bilalmuhammadnaveed/arduino-battery-voltage-tester/docs/ExhibitionTitlePage.pdf

# Battery Voltage Tester

# Using Arduino and LCD Display

Department of Computer Engineering
