bilalmuhammadnaveed/arduino-battery-voltage-tester/SchematicDiagram/schematicDiagram.pdf

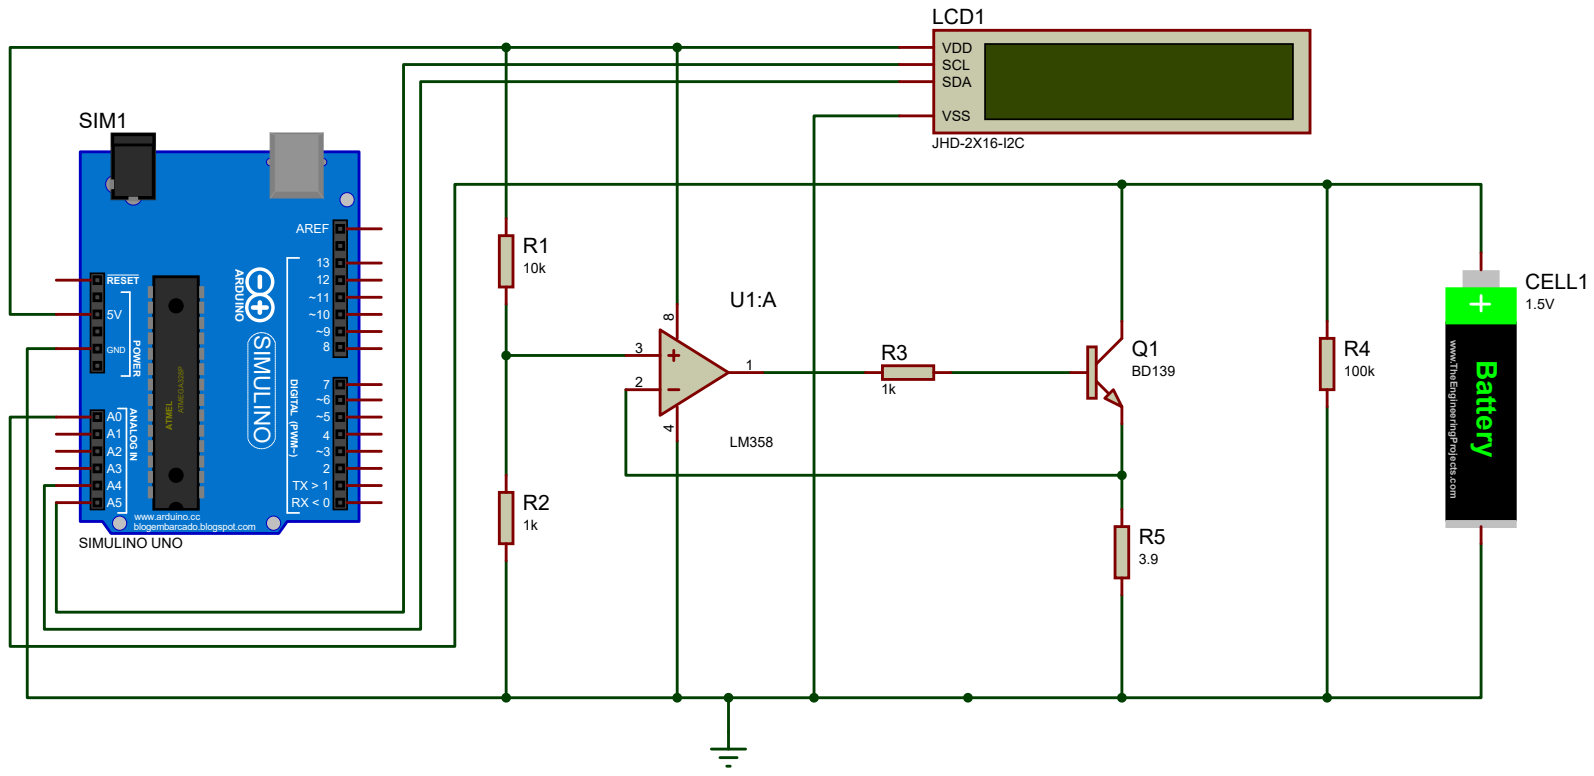
[picture p5: page 1]
R4 DIGITAL (PWM~); 100k ANALOG IN; AREF; RESET; GND; POWER; ATMEGA³²⁸P ATMEL; www.arduino.cc blogembarcado.blogspot.com SIMULINO UNO; VSS; SCL; VDD; SDA; LCD1; JHD-2X16-I2C; Battery www.TheEngineeringProjects.com; CELL1

SIM1
TX > 1 SIMULINO ARDUINO
